robopoly-pi/Kit_Prisme_NEW/footprint/PCA9685PW_118.step

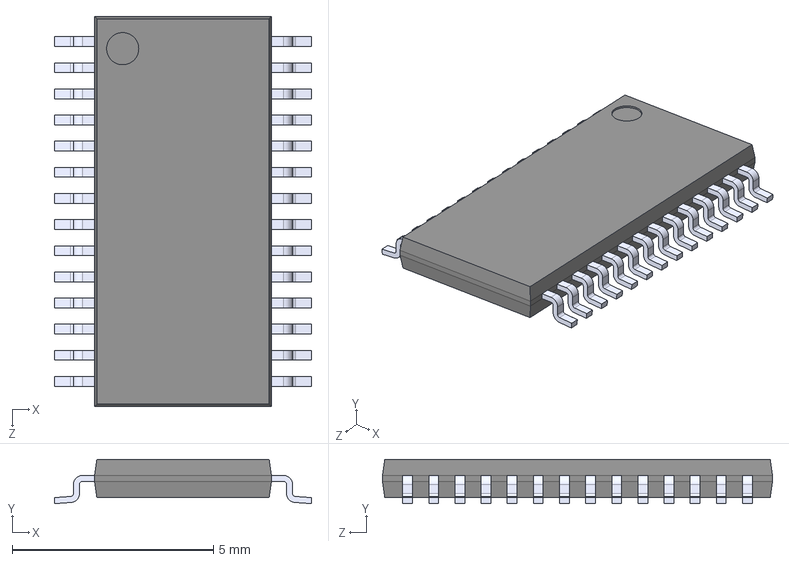
[picture p1: CAD file, 2025-11-15]
footprint/PCA9685PW_118.step
6.40 x 1.10 x 9.70 mm
