robopoly-pi/Kit_Prisme_NEW/footprint/ITR-9909.stp

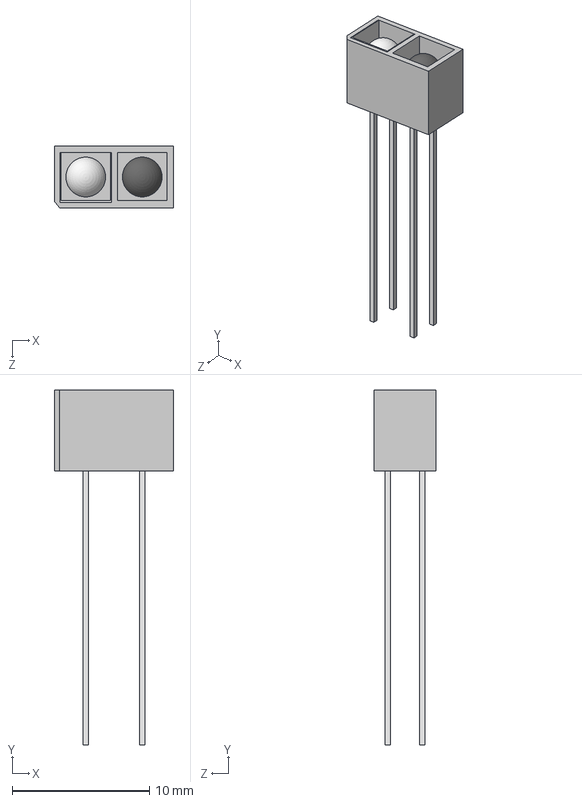
[picture p2: CAD file, 2025-11-15]
footprint/ITR-9909.stp
8.70 x 25.9 x 4.50 mm
