robopoly-pi/Kit_Prisme_NEW/exports/kit-prisme_schematic.pdf

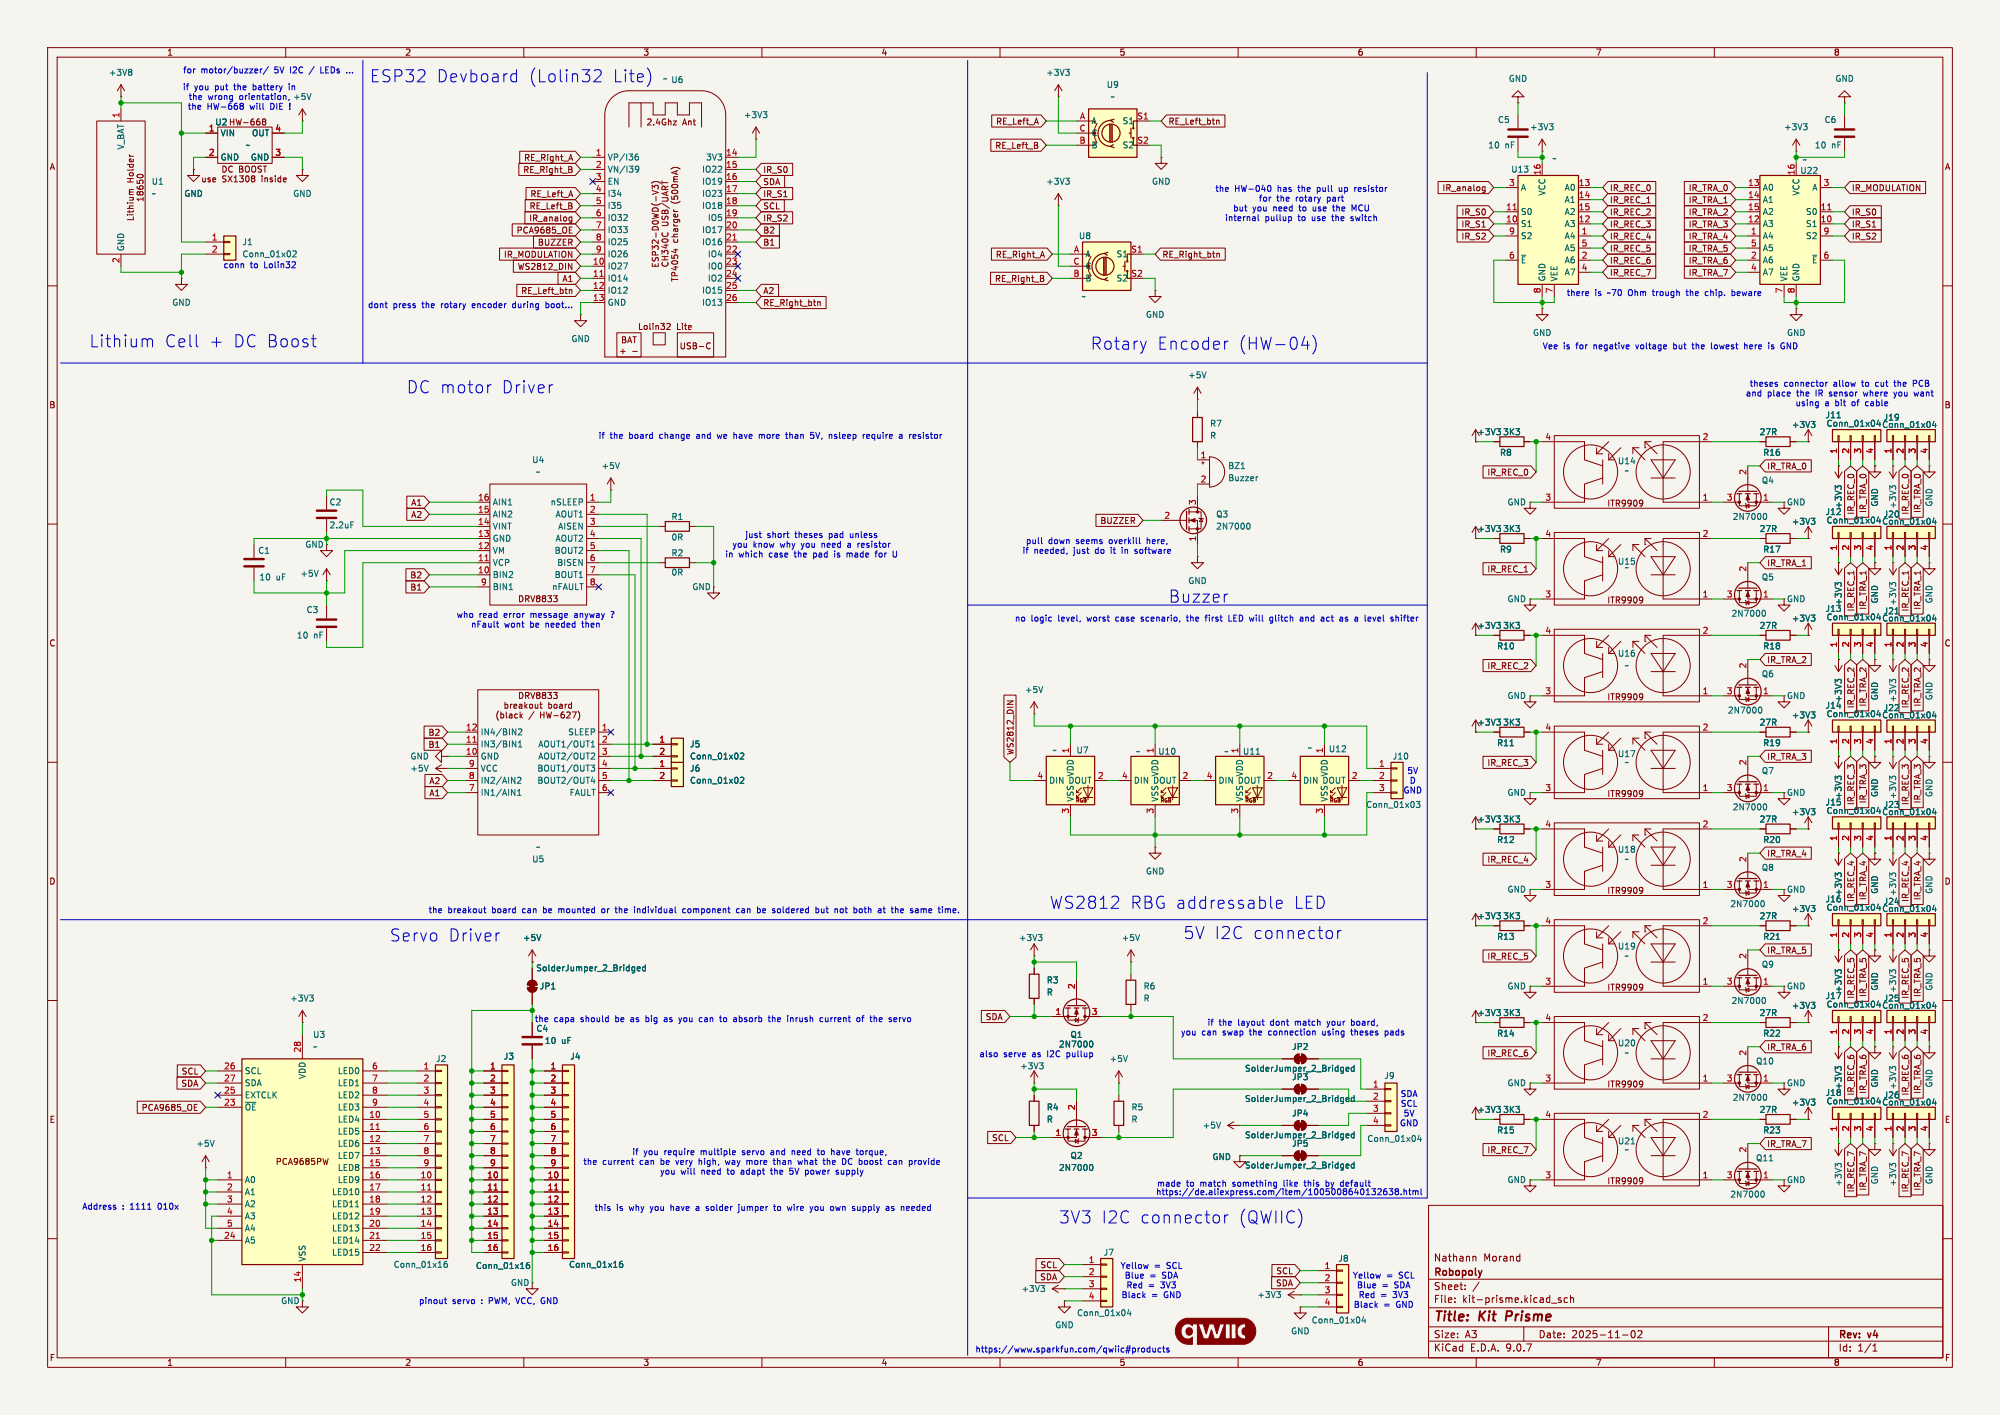
[picture p3: page 1]

if you put the battery in
the wrong orientation,

for the rotary part but you need to use the MCU

there is ~70 Ohm trough the chip. beware

dont press the rotary encoder during boot... DC motor Driver

if the board change and we have more than 5V, nsleep require a resistor Lithium Cell + DC Boost

and place the IR sensor where you want using a bit of cable

just short theses pad unless
you know why you need a resistor
in which case the pad is made for U

if needed, just do it in software

who read error message anyway ?
nFault wont be needed then

the capa should be as big as you can to absorb the inrush current of the servo
J3 Conn_01x16

also serve as I2C pullup

the current can be very high, way more than what the DC boost can provide

you will need to adapt the 5V power supply

this is why you have a solder jumper to wire you own supply as needed

Yellow = SCL Blue = SDA Red = 3V3 Black = GND

Id: 1/1 Title: Kit Prisme

https://www.sparkfun.com/qwiic#products
