robopoly-pi/Kit_Prisme_NEW/exports/kit-prisme_layout.pdf

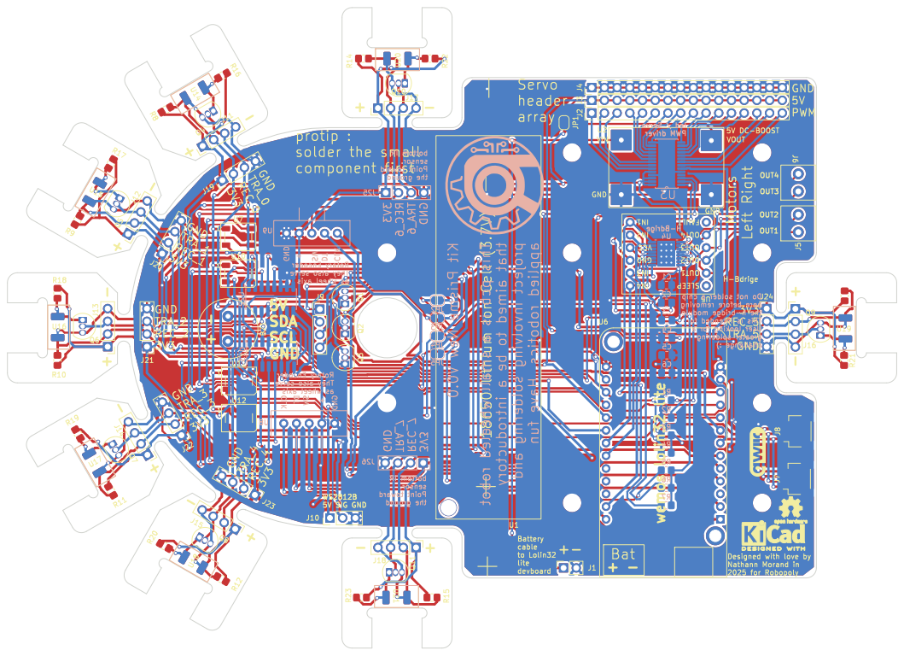
[picture p4: page 1]

Designed with love by Nathann Morand in
