robopoly-pi/Kit_Prisme_NEW/kit-prisme.kicad_pcb

## KiCad design kit-prisme.kicad_pcb (2026-03-15)

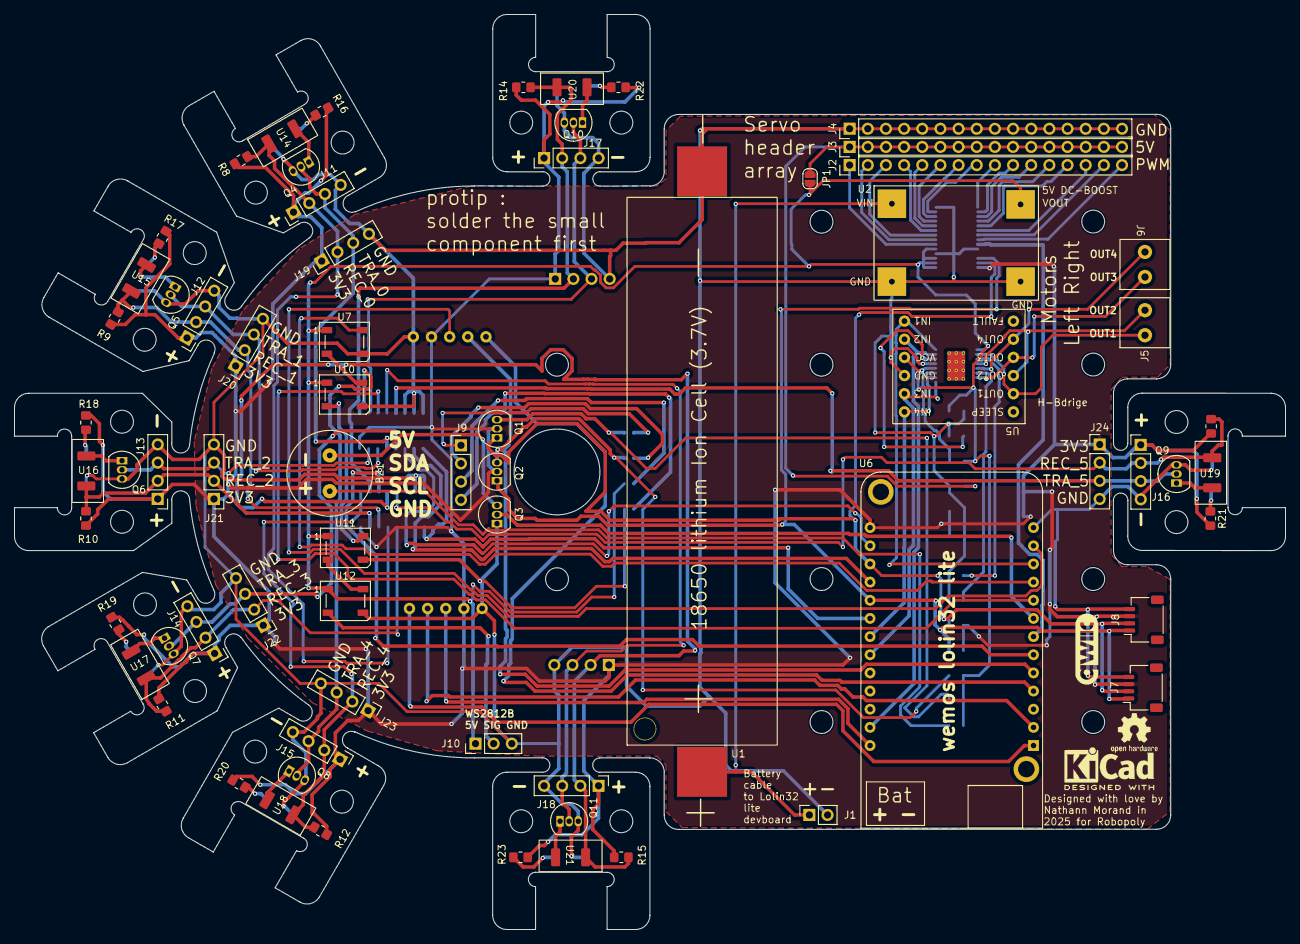
[picture p5: board kit-prisme.kicad_pcb from above]

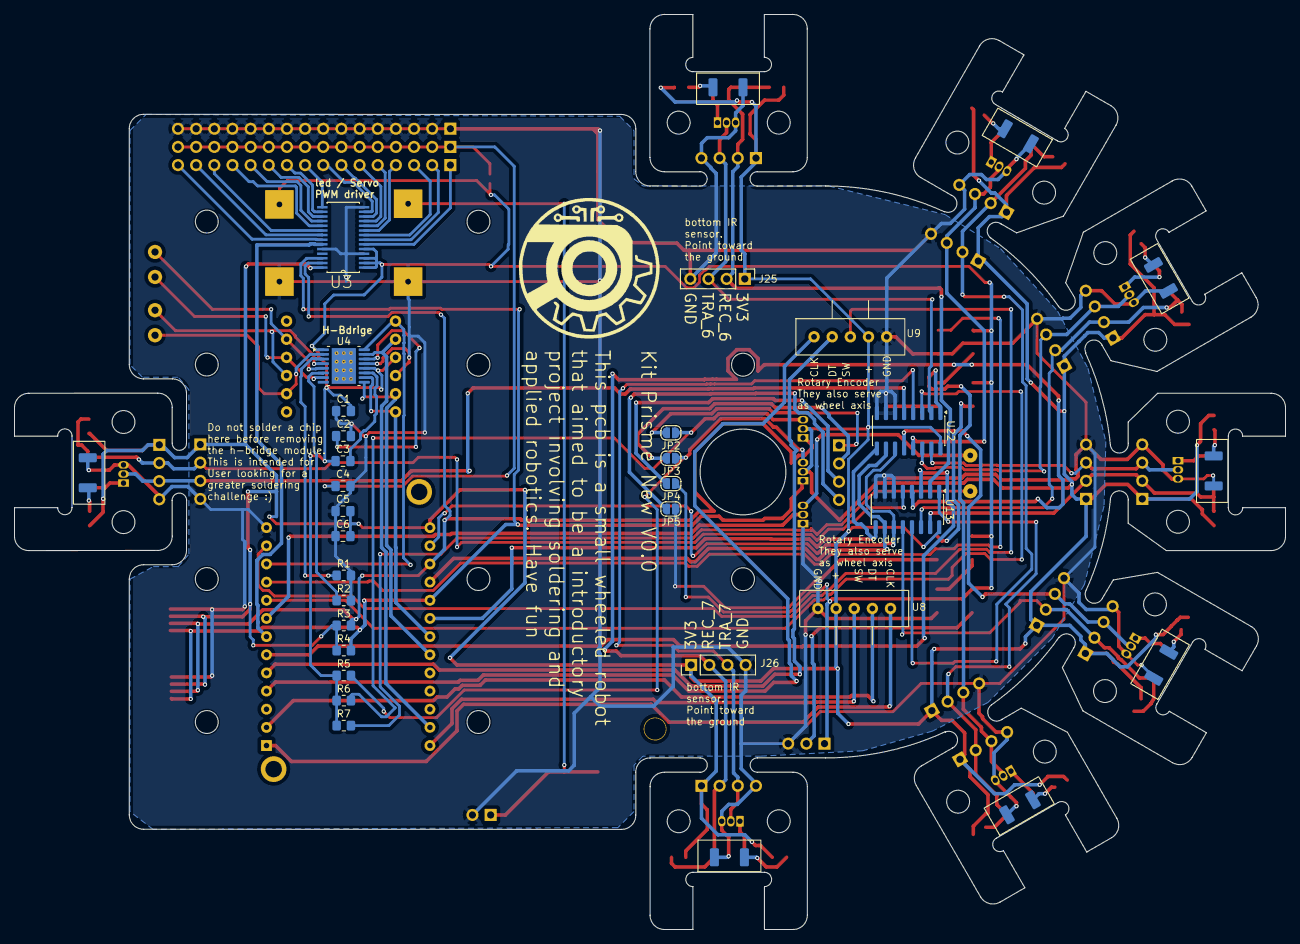
[picture p6: board kit-prisme.kicad_pcb from below]

Board: 2 copper layers, 177.8 x 128.0 mm, 94 parts (25 on the bottom side), 93 nets.

Parts:
BZ1: Buzzer; Buzzer_12mm_diam_5mm_pitch
C1, C4: 10 uF; C_0805_2012Metric_Pad1.18x1.45mm_HandSolder
C2: 2.2uF; C_0805_2012Metric_Pad1.18x1.45mm_HandSolder
C3, C5, C6: 10 nF; C_0805_2012Metric_Pad1.18x1.45mm_HandSolder
J1: Conn_01x02; PinSocket_1x02_P2.54mm_Vertical
J2, J3, J4: Conn_01x16; PinHeader_1x16_P2.54mm_Vertical
J5, J6: Conn_01x02; Bornier
J7, J8: Conn_01x04; JST_SH_SM04B-SRSS-TB_1x04-1MP_P1.00mm_Horizontal
J9, J11, J12, J13, J14, J15, J16, J17, J18, J19, J20, J21, J22, J23, J24, J25, J26: Conn_01x04; PinHeader_1x04_P2.54mm_Vertical
J10: Conn_01x03; PinHeader_1x03_P2.54mm_Vertical
JP1, JP2, JP3, JP4, JP5: SolderJumper_2_Bridged; SolderJumper-2_P1.3mm_Open_RoundedPad1.0x1.5mm
Q1, Q2, Q3, Q4, Q5, Q6, Q7, Q8, Q9, Q10, Q11: 2N7000; TO-92_Inline
R1, R2: 0R; R_0805_2012Metric_Pad1.20x1.40mm_HandSolder
R3, R4, R5, R6, R7, R8, R9, R10, R11, R12, R13, R14, R15, R16, R17, R18, R19, R20, R21, R22, R23: R; R_0805_2012Metric_Pad1.20x1.40mm_HandSolder
U1: Battery_Holder_18650_robop
U2: HW-668
U3: SOP65P640X110-28N
U4: HTSSOP-16-1EP_4.4x5mm_P0.65mm_EP3.4x5mm_Mask2.46x2.31mm_The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
U5: HW-627_DRV8833
U6: WEMOS_LoLin32_Lite
U7, U10, U11, U12: LED_WS2812B_PLCC4_5.0x5.0mm_P3.2mm
U8, U9: encoder
U13, U22: SOIC-16_3.9x9.9mm_P1.27mm
U14, U15, U16, U17, U18, U19, U20, U21: ITR_9909_Horizontal

Connections:
+3V3: C5.2, C6.2, J7.3, J8.3, J11.1, J12.1, J13.1, J14.1, J15.1, J16.1, J17.1, J18.1, J19.1, J20.1, J21.1, J22.1, J23.1, J24.1, J25.1, J26.1, Q1.2 (G), Q2.2 (G), R3.1, R4.1, R8.1, R9.1, R10.1, R11.1, R12.1, R13.1, R14.1, R15.1, R16.2, R17.2, R18.2, R19.2, R20.2, R21.2, R22.2, R23.2, U3.28 (VDD), U6.14 (3V3), U8.C, U9.C, U13.16 (VCC), U22.16 (VCC)
+3V8: J1.1, U1.1 (V_BAT), U2.1 (VIN)
+5V: C1.2, C3.1, J10.1, JP1.1 (A), JP4.1 (A), R5.1, R6.1, R7.1, U2.4 (OUT), U3.1 (A0), U3.2 (A1), U3.3 (A2), U3.5 (A4), U4.1 (nSLEEP), U4.12 (VM), U5.9 (VCC), U7.1 (VDD), U10.1 (VDD), U11.1 (VDD), U12.1 (VDD)
A1: U4.16 (AIN1), U5.7 (IN1/AIN1), U6.11 (IO14)
A2: U4.15 (AIN2), U5.8 (IN2/AIN2), U6.25 (IO15)
B1: U4.9 (BIN1), U5.11 (IN3/BIN1), U6.21 (IO16)
B2: U4.10 (BIN2), U5.12 (IN4/BIN2), U6.20 (IO17)
BUZZER: Q3.2 (G), U6.8 (IO25)
GND: C1.1, C2.2, C4.2, C5.1, C6.1, J1.2, J4.1, J4.2, J4.3, J4.4, J4.5, J4.6, J4.7, J4.8, J4.9, J4.10, J4.11, J4.12, J4.13, J4.14, J4.15, J4.16, J7.4, J8.4, J10.3, J11.4, J12.4, J13.4, J14.4, J15.4, J16.4, J17.4, J18.4, J19.4, J20.4, J21.4, J22.4, J23.4, J24.4, J25.4, J26.4, JP5.1 (A), Q3.1 (S), Q4.3 (D), Q5.3 (D), Q6.3 (D), Q7.3 (D), Q8.3 (D), Q9.3 (D), Q10.3 (D), Q11.3 (D), R1.2, R2.2, U1.2 (GND), U2.2 (GND), U2.3 (GND), U3.4 (A3), U3.14 (VSS), U3.24 (A5), U4.13 (GND), U5.10 (GND), U6.13 (GND), U7.3 (VSS), U8.S2, U9.S2, U10.3 (VSS), U11.3 (VSS), U12.3 (VSS), U13.6 (~E), U13.7 (VEE), U13.8 (GND), U14.3, U15.3, U16.3, U17.3, U18.3, U19.3, U20.3, U21.3, U22.6 (~E), U22.7 (VEE), U22.8 (GND)
IR_MODULATION: U6.9 (IO26), U22.3 (A)
IR_REC_0: J11.2, J19.2, R8.2, U13.13 (A0), U14.4
IR_REC_1: J12.2, J20.2, R9.2, U13.14 (A1), U15.4
IR_REC_2: J13.2, J21.2, R10.2, U13.15 (A2), U16.4
IR_REC_3: J14.2, J22.2, R11.2, U13.12 (A3), U17.4
IR_REC_4: J15.2, J23.2, R12.2, U13.1 (A4), U18.4
IR_REC_5: J16.2, J24.2, R13.2, U13.5 (A5), U19.4
IR_REC_6: J17.2, J25.2, R14.2, U13.2 (A6), U20.4
IR_REC_7: J18.2, J26.2, R15.2, U13.4 (A7), U21.4
IR_S0: U6.15 (IO22), U13.11 (S0), U22.11 (S0)
IR_S1: U6.17 (IO23), U13.10 (S1), U22.10 (S1)
IR_S2: U6.19 (IO5), U13.9 (S2), U22.9 (S2)
IR_TRA_0: J11.3, J19.3, Q4.2 (G), U22.13 (A0)
IR_TRA_1: J12.3, J20.3, Q5.2 (G), U22.14 (A1)
IR_TRA_2: J13.3, J21.3, Q6.2 (G), U22.15 (A2)
IR_TRA_3: J14.3, J22.3, Q7.2 (G), U22.12 (A3)
IR_TRA_4: J15.3, J23.3, Q8.2 (G), U22.1 (A4)
IR_TRA_5: J16.3, J24.3, Q9.2 (G), U22.5 (A5)
IR_TRA_6: J17.3, J25.3, Q10.2 (G), U22.2 (A6)
IR_TRA_7: J18.3, J26.3, Q11.2 (G), U22.4 (A7)
IR_analog: U6.6 (IO32), U13.3 (A)
unnamed: BZ1.1 (+), R7.2
unnamed: BZ1.2 (-), Q3.3 (D)
unnamed: J2.1, U3.6 (LED0)
unnamed: J2.2, U3.7 (LED1)
unnamed: J2.3, U3.8 (LED2)
unnamed: J2.4, U3.9 (LED3)
unnamed: J2.5, U3.10 (LED4)
unnamed: J2.6, U3.11 (LED5)
unnamed: J2.7, U3.12 (LED6)
unnamed: J2.8, U3.13 (LED7)
unnamed: J2.9, U3.15 (LED8)
unnamed: J2.10, U3.16 (LED9)
unnamed: J2.11, U3.17 (LED10)
unnamed: J2.12, U3.18 (LED11)
unnamed: J2.13, U3.19 (LED12)
unnamed: J2.14, U3.20 (LED13)
unnamed: J2.15, U3.21 (LED14)
unnamed: J2.16, U3.22 (LED15)
unnamed: C4.1, J3.1, J3.2, J3.3, J3.4, J3.5, J3.6, J3.7, J3.8, J3.9, J3.10, J3.11, J3.12, J3.13, J3.14, J3.15, J3.16, JP1.2 (B)
unnamed: J5.1, U4.2 (AOUT1), U5.2 (AOUT1/OUT1)
unnamed: J5.2, U4.4 (AOUT2), U5.3 (AOUT2/OUT2)
unnamed: J6.1, U4.7 (BOUT1), U5.4 (BOUT1/OUT3)
unnamed: J6.2, U4.5 (BOUT2), U5.5 (BOUT2/OUT4)
unnamed: J9.1, JP2.2 (B)
unnamed: J9.2, JP3.2 (B)
unnamed: J9.3, JP4.2 (B)
unnamed: J9.4, JP5.2 (B)
unnamed: J10.2, U12.2 (DOUT)
unnamed: JP2.1 (A), Q1.3 (D), R6.2
unnamed: JP3.1 (A), Q2.3 (D), R5.2
unnamed: Q4.1 (S), U14.1
unnamed: Q5.1 (S), U15.1
unnamed: Q6.1 (S), U16.1
unnamed: Q7.1 (S), U17.1
unnamed: Q8.1 (S), U18.1
unnamed: Q9.1 (S), U19.1
unnamed: Q10.1 (S), U20.1
unnamed: Q11.1 (S), U21.1
unnamed: R16.1, U14.2
unnamed: R17.1, U15.2
unnamed: R18.1, U16.2
unnamed: R19.1, U17.2
unnamed: R20.1, U18.2
unnamed: R21.1, U19.2
unnamed: R22.1, U20.2
unnamed: R23.1, U21.2
unnamed: R1.1, U4.3 (AISEN)
unnamed: R2.1, U4.6 (BISEN)
unnamed: C3.2, U4.11 (VCP)
unnamed: C2.1, U4.14 (VINT)
unnamed: U7.2 (DOUT), U10.4 (DIN)
unnamed: U10.2 (DOUT), U11.4 (DIN)
unnamed: U11.2 (DOUT), U12.4 (DIN)
PCA9685_OE: U3.23 (~OE), U6.7 (IO33)
RE_Left_A: U6.4 (I34), U9.A
RE_Left_B: U6.5 (I35), U9.B
RE_Left_btn: U6.12 (IO12), U9.S1
RE_Right_A: U6.1 (VP/I36), U8.A
RE_Right_B: U6.2 (VN/I39), U8.B
RE_Right_btn: U6.26 (IO13), U8.S1
SCL: J7.1, J8.1, Q2.1 (S), R4.2, U3.26 (SCL), U6.18 (IO18)
SDA: J7.2, J8.2, Q1.1 (S), R3.2, U3.27 (SDA), U6.16 (IO19)
WS2812_DIN: U6.10 (IO27), U7.4 (DIN)
