robopoly-pi/Kit_Prisme_NEW/(commit log)

2025-11-12 Initial commit of KiCad project
    [kit-prisme.kicad_pcb, kit-prisme.kicad_sch]
2025-11-12 Add .gitignore for KiCad
2025-11-12 Added action to compile PDF from schematic + layout
2025-11-13 Update KiCad repository to version 9.0
2025-11-13 Specify layers in PCB PDF export command
    Updated PDF export command to specify layers for PCB files.
2025-11-13 schematic improvment + exluded backup folder from git
    [kit-prisme.kicad_sch]
2025-11-15 assigned footprint to each component, ready to route
    [ITR-9909.stp, PCA9685PW_118.step, kit-prisme.kicad_pcb, kit-prisme.kicad_sch]
2025-11-15 Auto-export KiCad PDFs
2025-11-17 looking for a good PCB layout
    [kit-prisme.kicad_pcb, kit-prisme.kicad_sch]
2025-11-18 layout is almost ready
    [kit-prisme.kicad_pcb]
2025-11-18 fine tuning layout
    [kit-prisme.kicad_pcb]
2025-11-24 updated some footprint + finnished rough layout
    now its a matter of cleanly laying out the silkscreen, label, move a bit the footprint to avoid collision but rough outline is good.
    [kit-prisme.kicad_pcb]
2025-11-25 redit bouard edge cut, shrinked a bit the board
    [kit-prisme.kicad_pcb]
2025-11-26 improved silkscreen
    added instruction and naming of component
    [kit-prisme.kicad_pcb]
2025-11-26 routed the PCB
    [kit-prisme-B_Cu.gbr, kit-prisme-B_Mask.gbr, kit-prisme-B_Silkscreen.gbr, kit-prisme-Edge_Cuts.gbr, kit-prisme-F_Cu.gbr, kit-prisme-F_Mask.gbr, kit-prisme-F_Silkscreen.gbr, kit-prisme-NPTH.drl]
2026-03-15 assembling test version, added issue / improvment
    [kit-prisme.kicad_pcb, kit-prisme.kicad_sch]
